StarkJohan/Balboa-GS-WiFi/(commit log)

2026-07-17 Rewrite as PlatformIO project with WiFi/MQTT/OTA hardening
    Ports the original Arduino IDE sketch into this fleet's PlatformIO
    conventions: bounded boot connects, non-blocking reconnect, HA MQTT
    discovery, ArduinoOTA. Adds HA sensors/controls for water/set temp
    (with retroactive blink-based confirmation), heater/pump/light status,
    hard-wired button entities, and a number entity that drives the set
    temperature via simulated button presses. Credentials moved out of
    source into a gitignored secrets.h (see secrets.h.example).
2026-07-18 Add RGB status LED, raw-frame/last-button diagnostics, and docs
    Status LED (FastLED, WS2812B on D4) shows WiFi+MQTT connectivity as a
    full-color HA light entity - green/red, read-only (command topics are
    never subscribed to, so UI interaction is a no-op and the real color
    reasserts on the next update).
    _raw_frame surfaces the captured protocol bits in README's 7-7-7-3
    chunk format; _last_physical_button surfaces the same info the old
    testTopic-only debug message carried. Both diagnostic, real-time.
    README/doc/controller-info.md: cross-referenced bit 23 against
    kgstorm's independently reverse-engineered GS100 project (likely a
    frame checksum, not "Pump 2/Blower" as previously speculated), a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
2026-07-18 Rename shared device model to "HA Bridge", simplify state publishing
    Device model changed from "SDM-HA bridge" to "HA Bridge" (kept in
    sync with SDM-Universal-Env's bubbelkopp/poolboard firmware).
    Collapsed publishState()/stateChanged()/PublishedSnapshot into a
    single publishStateIfNeeded() that builds the state JSON once and
    compares the serialized string against what was last published,
    instead of hand-maintaining the same field list in three places.
    Docs: added an HA MQTT discovery example screenshot, documented the
    bit-23/24-bit capture investigation and its outcome (parked - ESP8266
    ISR timing marginality, matching kgstorm's own findings), and added
    the firmware TODO list to doc/contr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
2026-07-18 Bump DEVICE_SW_VERSION to 0.3, matching README
2026-07-18 Use raw GPIO numbers instead of D1 mini Dx pin aliases
    This is a custom ESP8266 board, not a Wemos D1 mini, so the Dx
    silkscreen labels were misleading.
2026-08-06 Add WiFi diagnostics, fix display decoder, prep ESP32 port
    - Publish _rssi/_wifi_channel in the shared attributes JSON, register
    Uptime/Boottime/WiFi RSSI/WiFi channel diagnostic entities (named
    "... Spa" to disambiguate from SDM-Universal-Env's sibling board on
    the same shared "Bubbelkopp" HA device)
    - Fix lookup_LCD_character(): B0000001 (only the middle segment lit)
    was mis-decoded as "j" by the generic alphanumeric font - it's
    actually Balboa's own Priming Mode indicator ("--" on the real
    panel), confirmed live via a full boot-sequence capture
    - B1100111 now returns "P" (was "p"), matching the real panel's
    capitalization in the "Pr" priming readout
    - ESP32/ESP8266 dual-plat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
    [Balboa-GS-WiFi.cpp]
